balkan16/flood-early-warning-system/README.md

# Flood Early Warning System (ESP32 + GSM)

A low-cost flood early warning system with a solar-powered riverside sensor, built for a riverside neighborhood in Bekasi, Indonesia. A sensor node at the river reads the water level with float switches, plays voice alerts through a local siren, and sends SMS alerts over 2G GSM. A receiver node on a siren tower turns those SMS messages into the same pre-recorded voice alerts for the wider area. Residents also receive the SMS as a backup in case a siren fails.

**Status:** sensor node deployed (firmware V9.1) and in active development since January 2026.

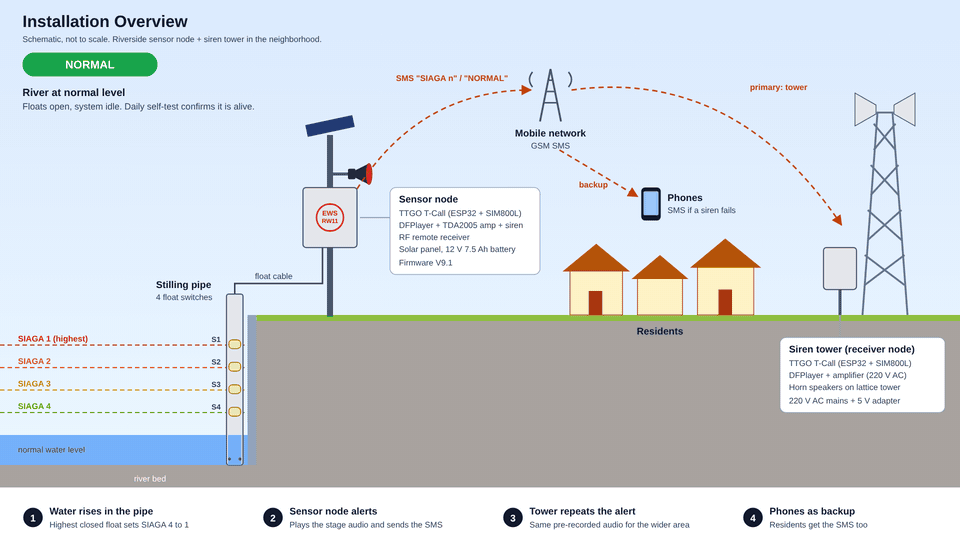
[picture p1: docs/flood-ews-animation.gif]
Animated walkthrough


*Water rises past each float, the sensor node alerts, the SMS reaches the tower and phones, then the river returns to normal. Full-quality video: [docs/flood-ews-animation.mp4](docs/flood-ews-animation.mp4).*

## How it works

1. **Sense.** Four float switches sit at different heights inside a stilling pipe at the river. Each one closes to ground when the water reaches it.
2. **Decide.** The ESP32 maps the highest active float to an alert level, from `SIAGA 4` (lowest float) to `SIAGA 1` (highest float, most severe). A level only counts after it holds for 5 s, and status changes are at least 60 s apart, so waves and debris do not cause false alarms.
3. **Alert locally.** A DFPlayer Mini plays a voice announcement for the level. A relay switches 12 V to the amplifier only while audio is playing, which saves battery.
4. **Alert remotely.** The SIM800L modem sends `NORMAL` or `SIAGA n` with a timestamp by SMS to the receiver node and to people's phones.
5. **Siren tower.** The receiver node reads each new SMS, matches `SIAGA 1` to `SIAGA 4` or `NORMAL`, and plays the pre-recorded audio for that stage on its own DFPlayer through the amplifier to the horn speakers. The audio repeats every 35 s until `NORMAL` arrives.
6. **Self-test.** Twice a day the sensor node plays a song and sends a "system working normally" SMS, so the operators know it is still alive.

A 4-channel RF remote can also force any alert level by hand, for drills or when someone sees flooding first.

## Software flow

```mermaid
sequenceDiagram
    autonumber
    participant F as Float switches
    participant S as Sensor node (ESP32)
    participant L as Local siren (DFPlayer + amp)
    participant G as GSM network
    participant R as Receiver node (tower)
    participant T as Tower siren (DFPlayer + amp)
    participant P as Phones (backup)

    F->>S: Float closes (water reaches level)
    Note over S: 200 ms filter, level holds 5 s,<br/>60 s since last status change
    S->>L: Play voice alert for SIAGA n<br/>(relay powers amp while playing)
    S->>G: SMS "EWS BEKASI: SIAGA n" + time
    G->>R: Primary number (receiver SIM)
    G->>P: Secondary number (NORMAL, SIAGA 1-2 only)
    R->>R: Read inbox, match level
    R->>T: Play pre-recorded audio for level n
    loop While level is active
        S->>L: Repeat voice alert (10/15/20 min, max 3)
        R->>T: Repeat audio every 35 s
    end
    F->>S: Water drops below all floats
    S->>G: SMS "EWS BEKASI: NORMAL"
    G->>R: NORMAL
    R->>T: Stop audio
```

## Alert levels (sensor node V9.1)

| Level | Trigger | Voice alert repeat | SMS sent to |
|---|---|---|---|
| SIAGA 1 | S1 (highest float) or remote A | every 10 min, max 3 | primary + secondary |
| SIAGA 2 | S2 or remote B | every 15 min, max 3 | primary + secondary |
| SIAGA 3 | S3 or remote C | every 20 min, max 3 | primary only |
| SIAGA 4 | S4 (lowest float) or remote D | every 20 min, max 3 | primary only |
| NORMAL | no float active | "normal" track, once | primary + secondary |

*Siaga* means "alert" in Indonesian. Level 1 is the most severe, following the Indonesian convention.

The tower receiver plays the same pre-recorded track for each stage and repeats it every 35 s until it receives `NORMAL`, so residents near the tower hear the alert for as long as it lasts.

## Hardware

The sensor node runs from a 12 V 7.5 Ah battery charged by a solar panel through a solar charge controller; a step-down converter supplies 5 V to the board, and the same battery powers the amplifier and siren. The siren tower runs on 220 V AC mains: a 5 V 5 A adapter powers the board, and the amplifier stays powered while a relay controls when it is used.

Hardware overview

| Part | Sensor node | Receiver node |
|---|---|---|
| LilyGO TTGO T-Call (ESP32 + SIM800L, IP5306 version 20200811) | ✓ | ✓ |
| Float switches (x4) in a stilling pipe | ✓ | |
| DFPlayer Mini MP3 module + microSD card | ✓ | ✓ |
| TDA2005 bridged (BTL) mono amplifier module, 12 V | ✓ | |
| Amplifier, 220 V AC | | ✓ |
| 4-channel RF remote receiver | ✓ | |
| Relay module | ✓ | ✓ |
| Siren / horn speakers | ✓ (12 V) | ✓ (on lattice tower) |
| 12 V 7.5 Ah battery, solar panel, solar charge controller | ✓ | |
| 12 V to 5 V step-down converter | ✓ | |
| 220 V AC to 5 V 5 A adapter | | ✓ |

### Pin map

| Function | Sensor node | Receiver node |
|---|---|---|
| Float S1 / S2 / S3 / S4 | 12 / 14 / 15 / 13 (INPUT_PULLUP, active LOW) | |
| RF remote A / B / C / D | 35 / 36 / 39 / 34 | |
| DFPlayer RX / TX / BUSY | 32 / 33 / 21 | 32 / 33 / not used |
| Relay (amplifier) | 2 | not driven by firmware |
| Status LED | 25 | 25 |
| SIM800L | LilyGO `utilities.h` | LilyGO `utilities.h` |

## Repository layout

```
firmware/
  sensor-node/      V9.1, the firmware deployed at the river
  receiver-node/    receiver firmware for the siren tower (deployed)
  archive/          earlier versions (sensor v1, receiver v1)
docs/
  flood-ews-animation.gif / .mp4
  hardware-diagram.svg
```

## Setup

1. Install the ESP32 board package in the Arduino IDE and select **ESP32 Dev Module**.
2. Install the libraries **TinyGSM** and **DFRobotDFPlayerMini**.
3. Copy `utilities.h` from LilyGO's [T-Call SIM800 examples](https://github.com/Xinyuan-LilyGO/LilyGo-T-Call-SIM800) into each firmware folder.
4. In `firmware/sensor-node`, copy `config.example.h` to `config.h` and fill in the phone numbers. `config.h` is git-ignored. The receiver needs no configuration.
5. Put the MP3 files on each DFPlayer's microSD card: `0001` to `0004` for SIAGA 1 to 4 (both nodes), plus `0005` for NORMAL and `0006` and `0007` for the daily self-test songs (sensor node).
6. **The tower receiver's SIM is always the sensor node's primary number** (`PRIMARY_NUMBER`). The secondary number is a person's phone for backup alerts; it never receives SIAGA 3, SIAGA 4, or the daily self-test.

## Known issues

- **Daily self-test hours.** The comments say 10:00 and 20:00, but the code checks hours 6 and 22. This may be a time-zone offset from the network clock; it needs checking on the device.
- **`S4_INTERVAL` is unused.** SIAGA 4 reuses the SIAGA 3 interval. Both are 20 min, so behaviour is the same today.
- **Blocking time queries.** `getTimestamp()` sends an AT command every 2 s for debug output, which slows the main loop.

## Roadmap

- Add Wi-Fi as an alternative link between the sensor node and the siren tower. Both posts have Wi-Fi nearby, so the ESP32's built-in Wi-Fi can carry alerts alongside SMS as a second path if the GSM network is slow or down.

## Credits

Electronics, water-level sensing, and firmware by [Balkan Assakandari](https://github.com/balkan16). The stilling pipe at the river and the siren on the tower were installed by the local community team.
