balkan16/flood-early-warning-system/(commit log)

2026-10-22 Receiver: play pre-recorded stage audio via DFPlayer
2026-10-22 Receiver stage audio; README cleanup
2026-10-23 Tower on 220 V AC; installation overview; README cleanup
2026-10-23 Add animated walkthrough; tower on 220 V AC; README cleanup
2026-10-23 Animated walkthrough; tower on 220 V AC; README cleanup
2026-10-23 Animated walkthrough; tower on 220 V AC; roadmap: Wi-Fi link
2026-10-23 Use deployed receiver firmware; tower on 220 V AC; animated walkthrough
